JQIamo/flux_gate_3_axis/flux_gate_3_axis.kicad_pcb

## KiCad design flux_gate_3_axis.kicad_pcb (2024-10-18)

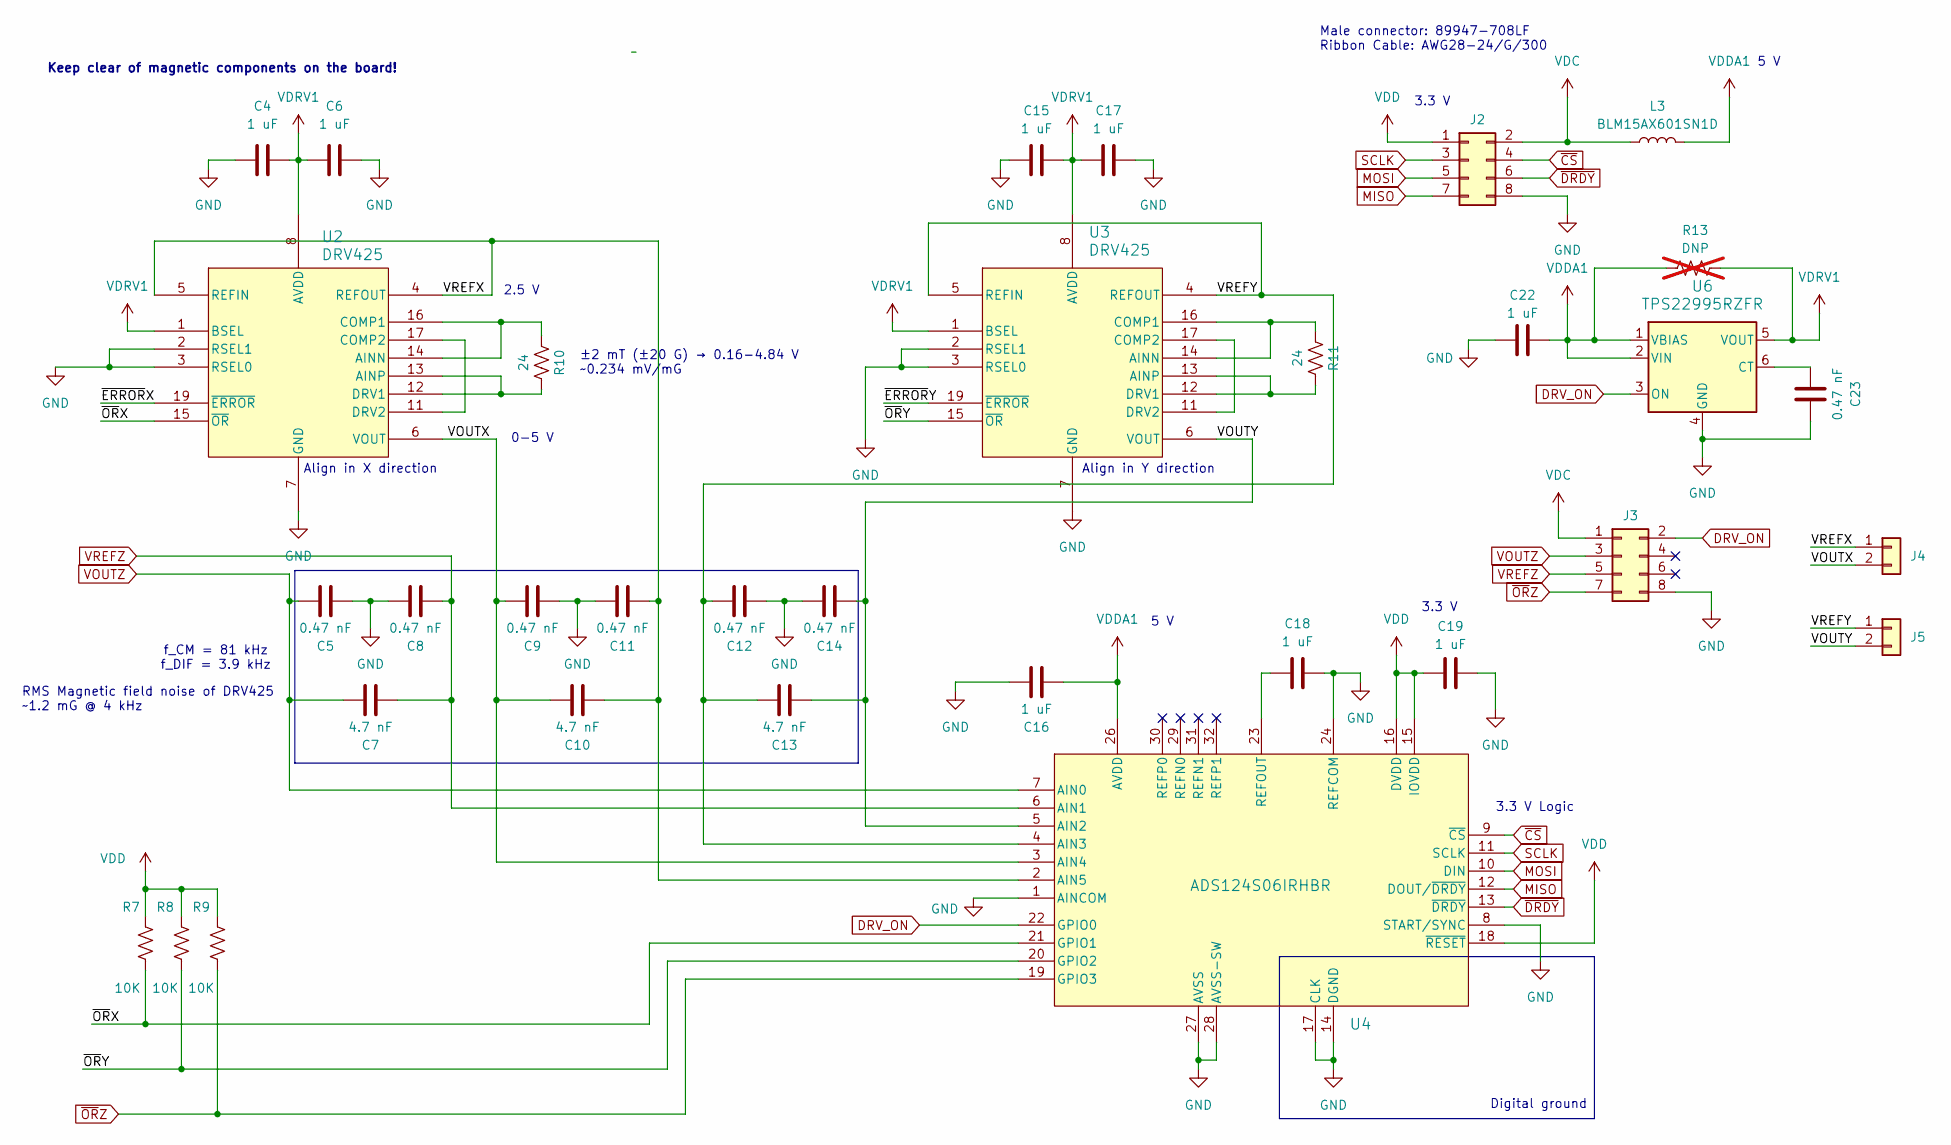
[picture p1: schematic x_y_axis.kicad_sch]

Parts:
C4, C6, C15, C16, C17, C18, C19, C22: 1 uF; C_0402_1005Metric; Digikey 490-10018-1-ND
C5, C8, C9, C11, C12, C14, C23: 0.47 nF; C_0402_1005Metric; Digikey 490-1297-1-ND
C7, C10, C13: 4.7 nF; C_0402_1005Metric; Digikey 490-GRM1555C1H472GE01DCT-ND
J2: Conn_02x04_Odd_Even; AMPHENOL_98464-G61-08LF; Digikey 609-6027-ND
J3: Conn_02x04_Odd_Even; PinHeader_2x04_P2.00mm_Vertical; Digikey A108094-ND
J4, J5: Conn_01x02; TestPoint_2Pads_Pitch2.54mm_Drill0.8mm
L3: BLM15AX601SN1D; L_0402_1005Metric; Digikey 490-5441-1-ND
R7, R8, R9: 10K; R_0402_1005Metric; Digikey 311-10KJRCT-ND
R10, R11: 24; R_0805_2012Metric; Digikey 13-RT0805BRD0724RLCT-ND
R13: DNP; R_0402_1005Metric; not fitted
U2, U3: DRV425; WQFN20_RTJ_TEX; Digikey 296-DRV425QWRTJRQ1CT-ND
U4: ADS124S06IRHBR; VQFN-32-1EP_5x5mm_P0.5mm_EP3.1x3.1mm; Digikey 296-ADS124S06IRHBRCT-ND
U6: TPS22995RZFR; WQFN6_RZF_TEX

Connections:
/x_y_axis/VOUTX: C9.1, C10.1, J4.2, U2.6 (VOUT), U4.3 (AIN4)
/x_y_axis/VOUTY: C13.2, C14.2, J5.2, U3.6 (VOUT), U4.5 (AIN2)
/x_y_axis/VREFX: C10.2, C11.2, J4.1, U2.4 (REFOUT), U2.5 (REFIN), U4.2 (AIN5)
/x_y_axis/VREFY: C12.1, C13.1, J5.1, U3.4 (REFOUT), U3.5 (REFIN), U4.4 (AIN3)
/x_y_axis/~ERRORX: U2.19 (~ERROR)
/x_y_axis/~ERRORY: U3.19 (~ERROR)
/x_y_axis/~ORX: R7.1, U2.15 (~OR), U4.21 (GPIO1)
/x_y_axis/~ORY: R8.1, U3.15 (~OR), U4.20 (GPIO2)
DRV_ON: J3.2, U4.22 (GPIO0), U6.3 (ON); also elsewhere on the board
GND: C4.1, C5.2, C6.1, C8.1, C9.2, C11.1, C12.2, C14.1, C15.1, C16.1, C17.1, C18.2, C19.2, C22.2, C23.1, J2.8, J3.8, U2.2 (RSEL1), U2.3 (RSEL0), U2.7 (GND), U2.10 (GND), U2.18 (GND), U2.20 (GND), U2.21 (GND), U3.2 (RSEL1), U3.3 (RSEL0), U3.7 (GND), U3.10 (GND), U3.18 (GND), U3.20 (GND), U3.21 (GND), U4.1 (AINCOM), U4.8 (START/SYNC), U4.14 (DGND), U4.17 (CLK), U4.24 (REFCOM), U4.27 (AVSS), U4.28 (AVSS-SW), U4.33 (PAD), U6.4 (GND); also elsewhere on the board
MISO: J2.7, U4.12 (DOUT/~DRDY); also elsewhere on the board
MOSI: J2.5, U4.10 (DIN); also elsewhere on the board
unnamed: R10.2, U2.14 (AINN), U2.16 (COMP1)
unnamed: R10.1, U2.12 (DRV1), U2.13 (AINP)
unnamed: U2.11 (DRV2), U2.17 (COMP2)
unnamed: R11.2, U3.14 (AINN), U3.16 (COMP1)
unnamed: R11.1, U3.12 (DRV1), U3.13 (AINP)
unnamed: U3.11 (DRV2), U3.17 (COMP2)
unnamed: C18.1, U4.23 (REFOUT)
unnamed: C23.2, U6.6 (CT)
SCLK: J2.3, U4.11 (SCLK); also elsewhere on the board
VDC: J2.2, J3.1, L3.2; also elsewhere on the board
VDD: C19.1, J2.1, R7.2, R8.2, R9.2, U4.15 (IOVDD), U4.16 (DVDD), U4.18 (~RESET); also elsewhere on the board
VDDA1: C16.2, C22.1, L3.1, R13.1, U4.26 (AVDD), U6.1 (VBIAS), U6.2 (VIN)
VDRV1: C4.2, C6.2, C15.2, C17.2, R13.2, U2.1 (BSEL), U2.8 (AVDD), U2.9 (AVDD), U3.1 (BSEL), U3.8 (AVDD), U3.9 (AVDD), U6.5 (VOUT)
VOUTZ: C5.1, C7.1, J3.3, U4.7 (AIN0); also elsewhere on the board
VREFZ: C7.2, C8.2, J3.5, U4.6 (AIN1); also elsewhere on the board
~CS: J2.4, U4.9 (~CS); also elsewhere on the board
~DRDY: J2.6, U4.13 (~DRDY); also elsewhere on the board
~ORZ: J3.7, R9.1, U4.19 (GPIO3); also elsewhere on the board

Notes on the sheet:
0-5 V
Align in X direction
Align in Y direction
RMS Magnetic field noise of DRV425 ~1.2 mG @ 4 kHz
5 V
3.3 V
Keep clear of magnetic components on the board!
Digital ground
2.5 V
3.3 V Logic
Male connector: 89947-708LF Ribbon Cable: AWG28-24/G/300
f_CM = 81 kHz f_DIF = 3.9 kHz
±2 mT (±20 G) → 0.16-4.84 V ~0.234 mV/mG

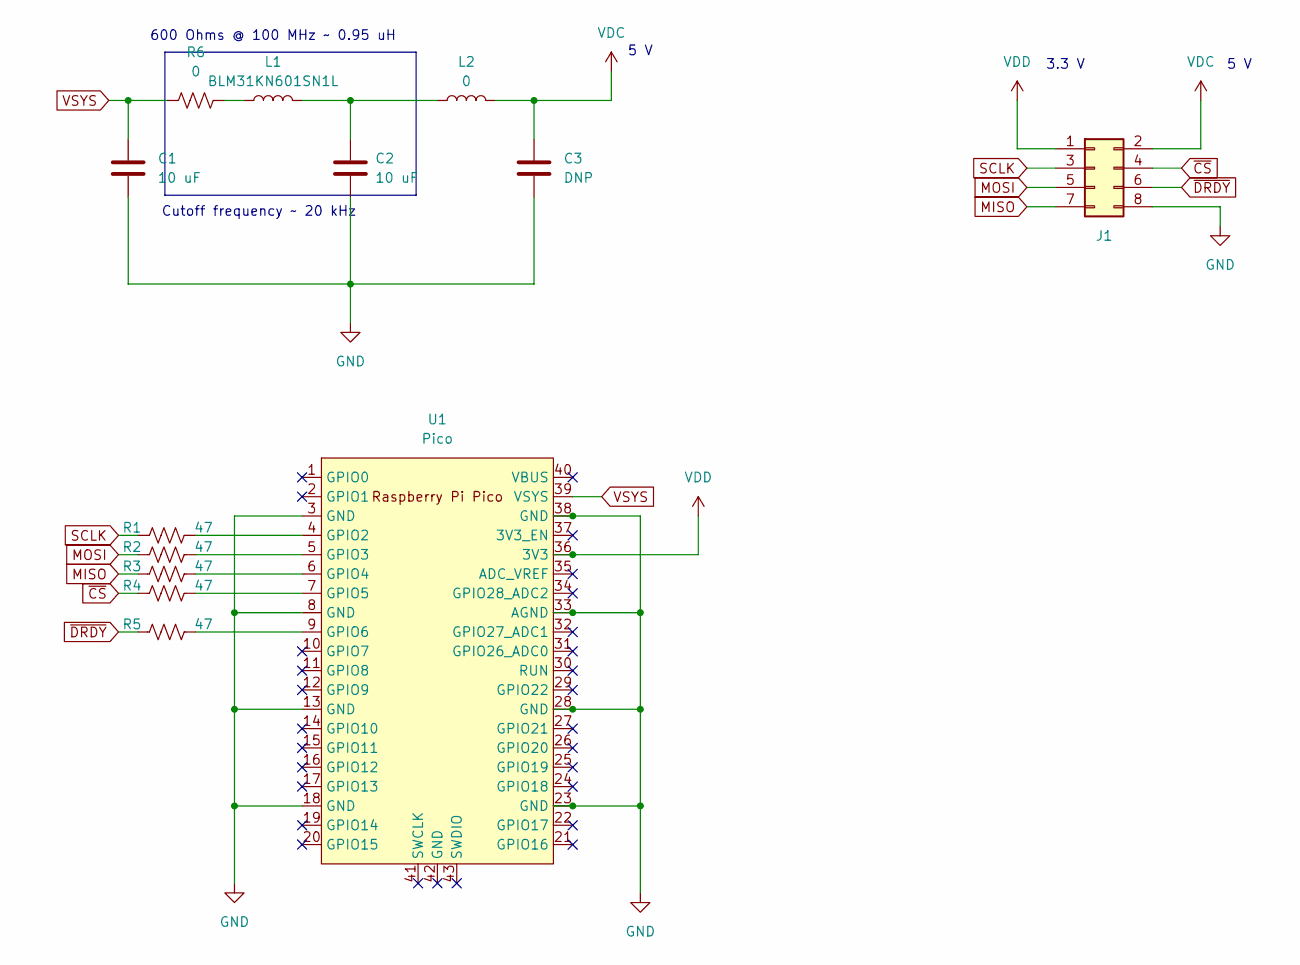
[picture p2: schematic power.kicad_sch]

Parts:
C1, C2: 10 uF; C_0603_1608Metric; Digikey 490-12323-1-ND
C3: DNP; C_0603_1608Metric
J1: Conn_02x04_Odd_Even; AMPHENOL_98464-G61-08LF; Digikey 609-6027-ND
L1: BLM31KN601SN1L; L_1206_3216Metric; Digikey 490-16533-1-ND
L2: 0; L_1206_3216Metric; Digikey 311-0.0ERCT-ND
R1, R2, R3, R4, R5: 47; R_0402_1005Metric; Digikey 311-47.0LRCT-ND
R6: 0; R_0805_2012Metric; Digikey 311-0.0ERCT-ND
U1: Pico; RPi_Pico_Connector

Connections:
GND: C1.2, C2.2, C3.2, J1.8, U1.3 (GND), U1.8 (GND), U1.13 (GND), U1.18 (GND), U1.23 (GND), U1.28 (GND), U1.33 (AGND), U1.38 (GND); also elsewhere on the board
MISO: J1.7, R3.1; also elsewhere on the board
MOSI: J1.5, R2.1; also elsewhere on the board
unnamed: C2.1, L1.2, L2.1
unnamed: L1.1, R6.2
unnamed: R1.2, U1.4 (GPIO2)
unnamed: R2.2, U1.5 (GPIO3)
unnamed: R3.2, U1.6 (GPIO4)
unnamed: R4.2, U1.7 (GPIO5)
unnamed: R5.2, U1.9 (GPIO6)
SCLK: J1.3, R1.1; also elsewhere on the board
VDC: C3.1, J1.2, L2.2; also elsewhere on the board
VDD: J1.1, U1.36 (3V3); also elsewhere on the board
VSYS: C1.1, R6.1, U1.39 (VSYS)
~CS: J1.4, R4.1; also elsewhere on the board
~DRDY: J1.6, R5.1; also elsewhere on the board

Notes on the sheet:
600 Ohms @ 100 MHz ~ 0.95 uH
Cutoff frequency ~ 20 kHz
5 V
3.3 V

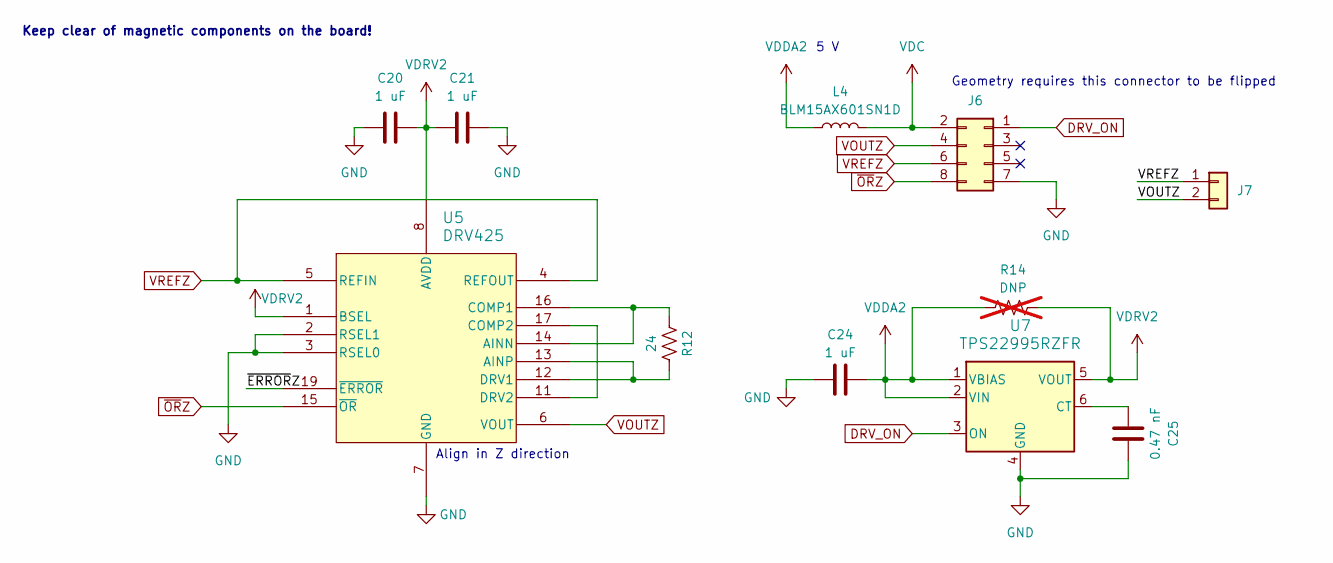
[picture p3: schematic z_axis.kicad_sch]

Parts:
C20, C21, C24: 1 uF; C_0402_1005Metric; Digikey 490-10018-1-ND
C25: 0.47 nF; C_0402_1005Metric; Digikey 490-1297-1-ND
J6: Conn_02x04_Odd_Even; PinHeader_2x04_P2.00mm_Vertical; Digikey 609-2574-ND
J7: Conn_01x02; TestPoint_2Pads_Pitch2.54mm_Drill0.8mm
L4: BLM15AX601SN1D; L_0402_1005Metric; Digikey 490-5441-1-ND
R12: 24; R_0805_2012Metric; Digikey 13-RT0805BRD0724RLCT-ND
R14: DNP; R_0402_1005Metric; not fitted
U5: DRV425; WQFN20_RTJ_TEX; Digikey 296-DRV425QWRTJRQ1CT-ND
U7: TPS22995RZFR; WQFN6_RZF_TEX

Connections:
/z_axis/~ERRORZ: U5.19 (~ERROR)
DRV_ON: J6.1, U7.3 (ON); also elsewhere on the board
GND: C20.1, C21.1, C24.2, C25.1, J6.7, U5.2 (RSEL1), U5.3 (RSEL0), U5.7 (GND), U5.10 (GND), U5.18 (GND), U5.20 (GND), U5.21 (GND), U7.4 (GND); also elsewhere on the board
unnamed: R12.2, U5.14 (AINN), U5.16 (COMP1)
unnamed: R12.1, U5.12 (DRV1), U5.13 (AINP)
unnamed: U5.11 (DRV2), U5.17 (COMP2)
unnamed: C25.2, U7.6 (CT)
VDC: J6.2, L4.2; also elsewhere on the board
VDDA2: C24.1, L4.1, R14.1, U7.1 (VBIAS), U7.2 (VIN)
VDRV2: C20.2, C21.2, R14.2, U5.1 (BSEL), U5.8 (AVDD), U5.9 (AVDD), U7.5 (VOUT)
VOUTZ: J6.4, J7.2, U5.6 (VOUT); also elsewhere on the board
VREFZ: J6.6, J7.1, U5.4 (REFOUT), U5.5 (REFIN); also elsewhere on the board
~ORZ: J6.8, U5.15 (~OR); also elsewhere on the board

Notes on the sheet:
Keep clear of magnetic components on the board!
Geometry requires this connector to be flipped
5 V
Align in Z direction

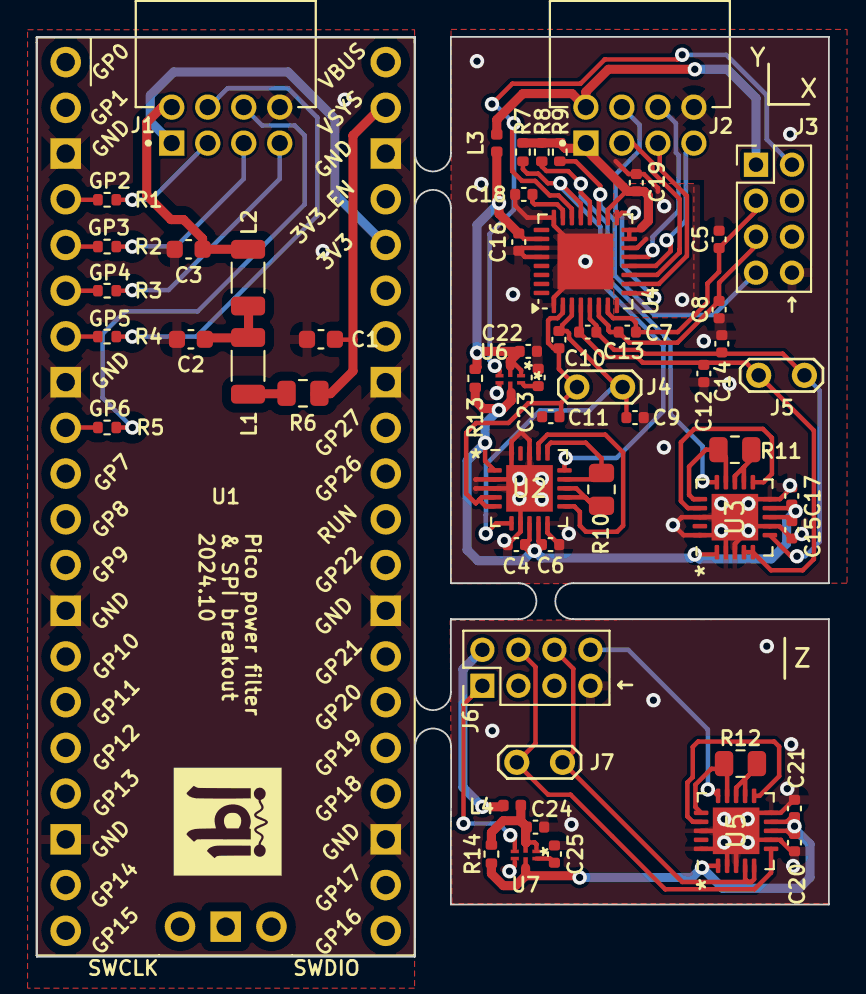
[picture p4: board flux_gate_3_axis.kicad_pcb from above]

Board: 4 copper layers, 44.0 x 51.1 mm, 57 parts (0 on the bottom side), 42 nets.
