JQIamo/flux_gate_3_axis/(commit log)

2024-10-18 init commit
    [flux_gate_3_axis.kicad_pcb, flux_gate_3_axis.kicad_sch, flux_gate_3_axis_stencil.kicad_pcb, power.kicad_sch, x_y_axis.kicad_sch, z_axis.kicad_sch]
2024-10-18 removed useless files
    [flux_gate_3_axis_stencil.kicad_pcb]
2024-10-18 added link to github repo
    [flux_gate_3_axis.kicad_pcb]
2024-10-18 fixed silkscreen
    [flux_gate_3_axis.kicad_pcb]
2024-10-18 improved ground connectivity
    [flux_gate_3_axis.kicad_pcb]
